keksoid/charybdis-wireless-mini-trackball-displaydongle/case/travel/preview/base.png

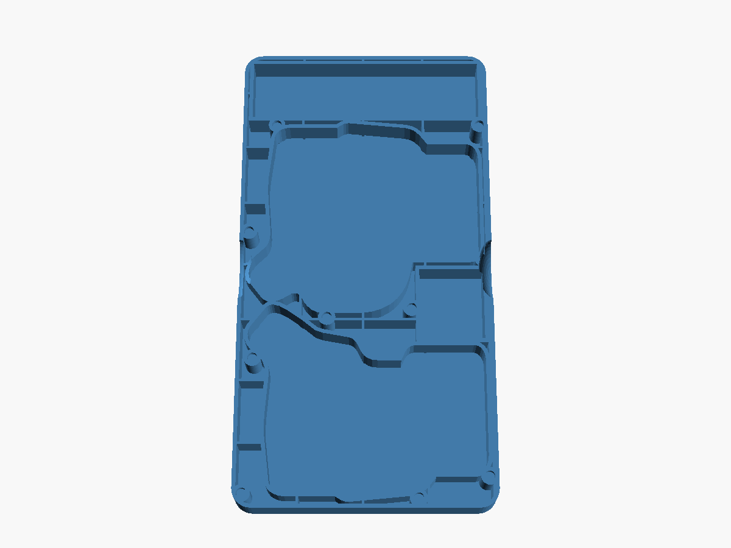
case/travel/preview/base.png
