keksoid/charybdis-wireless-mini-trackball-displaydongle/case/travel/preview/lid_inside.png

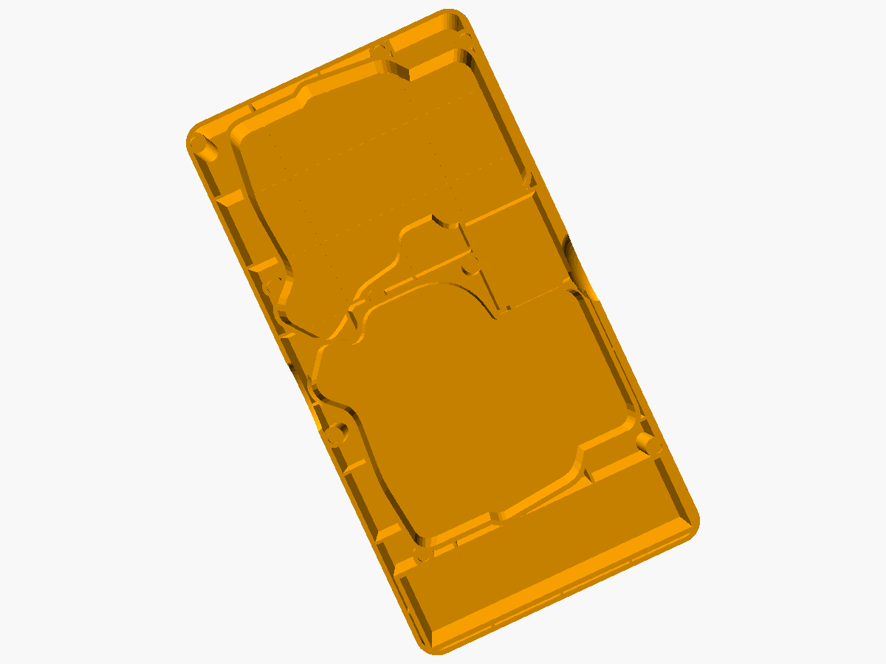
case/travel/preview/lid_inside.png
