keksoid/charybdis-wireless-mini-trackball-displaydongle/case/travel/stl/travel_case_base_fdm.stl

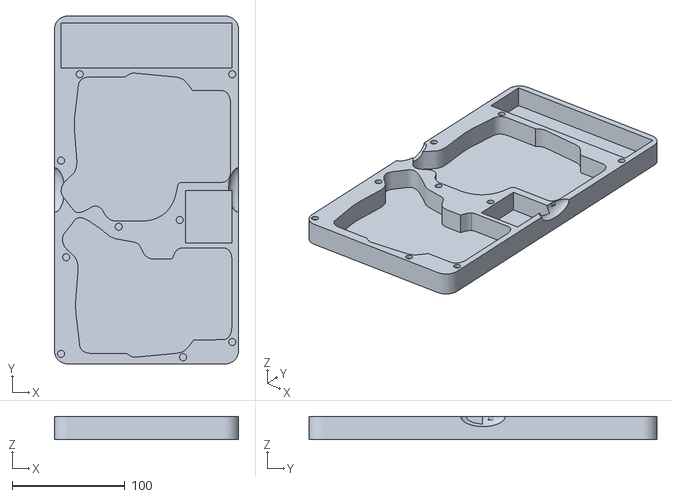
[picture p5: CAD file, 2026-11-10]
case/travel/stl/travel_case_base_fdm.stl
163.2 x 308.1 x 20.5
