keksoid/charybdis-wireless-mini-trackball-displaydongle/case/travel/stl/travel_case_lid_fdm.stl

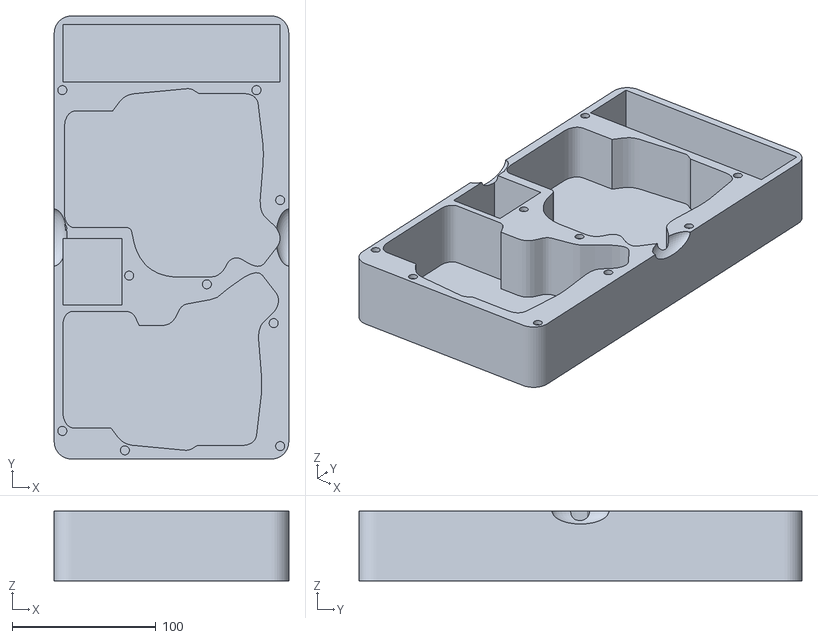
[picture p6: CAD file, 2026-11-10]
case/travel/stl/travel_case_lid_fdm.stl
163.2 x 308.1 x 48.5
