keksoid/charybdis-wireless-mini-trackball-displaydongle/case/travel/stl/travel_case_test_frame.stl

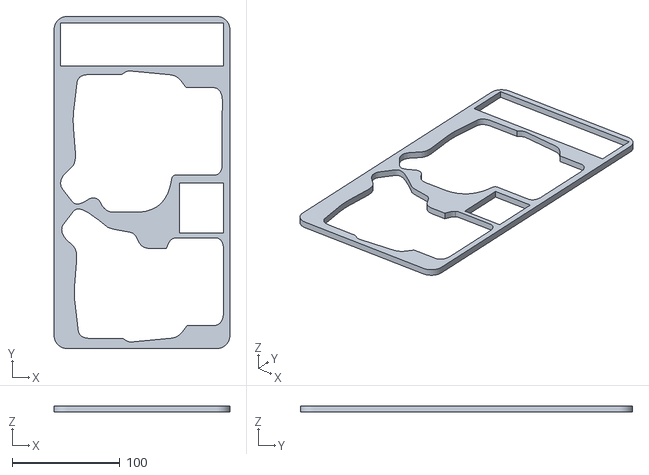
[picture p8: CAD file, 2026-11-10]
case/travel/stl/travel_case_test_frame.stl
163.2 x 308.1 x 6.00
