keksoid/charybdis-wireless-mini-trackball-displaydongle/case/travel/case_data.scad

// Generated by tools/build_case_data.py - do not edit by hand.
outer = [-130.76, -7.33, 32.41, 300.73];
z_pocket = -3.00; z_floor = -5.50; z_top = 63.50; clear = 0.00;
dongle_pocket = [-14.6, 99.9, 41.0, 46.2]; dongle_h = 53.50;
cable_pocket = [-124.76, 254.73, 151.17, 40.0];
magnets = [[-124.76, 1.67], [26.74, 249.17], [-124.76, 172.67], [26.74, 12.17], [-19.76, 120.17], [-120.26, 87.17], [-108.26, 249.17], [26.74, 153.17], [-73.76, 114.17], [-16.76, -1.33]];
module outline_left() polygon([[-123.65, 102.88], [-123.26, 105.48], [-122.22, 107.72], [-112.67, 120.09], [-111.62, 121.09], [-110.36, 121.8], [-109.03, 122.16], [-107.53, 122.21], [-104.01, 121.32], [-99.05, 118.69], [-89.12, 111.7], [-81.03, 105.13], [-76.39, 103.51], [-59.79, 100.47], [-57.64, 99.65], [-56.18, 98.53], [-54.96, 97.03], [-51.93, 91.08], [-50.15, 88.56], [-47.84, 86.8], [-45.01, 85.77], [-41.62, 85.4], [-26.72, 85.4], [-24.1, 91.07], [-22.94, 92.85], [-21.03, 94.47], [-18.57, 95.27], [19.21, 95.35], [20.86, 95.14], [22.25, 94.56], [23.87, 93.24], [25.09, 91.44], [25.96, 89.23], [26.4, 86.49], [26.4, 24.84], [25.97, 21.49], [24.77, 18.36], [23.59, 16.65], [22.31, 15.47], [20.84, 14.65], [19.03, 14.16], [-7.22, 14.07], [-11.88, 7.89], [-14.53, 5.24], [-16.13, 4.11], [-18.12, 3.13], [-21.87, 2.22], [-59.42, -1.33], [-61.26, -1.1], [-62.89, -0.55], [-66.99, 2.02], [-98.44, 2.05], [-101.73, 2.48], [-104.53, 3.58], [-105.81, 4.51], [-106.94, 5.76], [-107.79, 7.27], [-108.27, 8.8], [-111.71, 37.87], [-111.93, 43.86], [-111.79, 50.08], [-109.74, 75.77], [-109.81, 79.27], [-110.18, 82.03], [-111.1, 84.95], [-112.47, 87.23], [-119.55, 93.99], [-121.66, 96.57], [-123.18, 99.85]]);
module outline_right() polygon([[-124.76, 145.76], [-124.3, 149.03], [-122.79, 152.31], [-121.05, 154.53], [-113.56, 161.69], [-112.21, 163.96], [-111.3, 166.86], [-110.93, 169.65], [-110.86, 173.08], [-112.9, 198.85], [-113.04, 205.1], [-112.82, 211.12], [-109.38, 240.13], [-108.79, 241.9], [-108.06, 243.14], [-106.93, 244.39], [-105.65, 245.32], [-102.85, 246.42], [-99.56, 246.85], [-68.1, 246.88], [-64.04, 249.44], [-62.38, 250.0], [-60.53, 250.23], [-23.0, 246.68], [-19.28, 245.79], [-17.25, 244.79], [-15.65, 243.66], [-13.0, 241.02], [-8.34, 234.83], [17.86, 234.74], [19.7, 234.26], [21.13, 233.48], [22.42, 232.31], [23.46, 230.88], [24.74, 227.84], [25.29, 224.06], [25.28, 162.42], [24.84, 159.67], [23.98, 157.47], [22.76, 155.67], [21.17, 154.36], [19.79, 153.77], [18.24, 153.55], [-18.55, 153.55], [-19.61, 153.2], [-20.6, 152.51], [-21.36, 151.44], [-23.05, 143.28], [-24.14, 139.6], [-25.38, 136.45], [-27.54, 132.38], [-30.63, 128.3], [-32.56, 126.41], [-35.34, 124.25], [-40.05, 121.73], [-45.69, 119.98], [-51.31, 119.22], [-75.79, 119.11], [-79.42, 119.65], [-82.04, 120.9], [-84.41, 122.97], [-85.92, 124.87], [-88.34, 129.17], [-89.47, 130.52], [-91.21, 131.74], [-93.19, 132.42], [-95.56, 132.4], [-97.48, 131.84], [-103.07, 128.52], [-106.43, 127.12], [-108.91, 126.67], [-111.24, 127.01], [-112.7, 127.79], [-113.78, 128.79], [-123.03, 140.71], [-124.25, 143.01]]);
module ceiling_left() polyhedron(points=[[-128.65, -6.33, 61.0], [31.41, -6.33, 61.0], [-128.65, 127.23, 61.0], [31.41, 127.23, 61.0], [-128.65, -6.33, -4.0], [31.41, -6.33, -4.0], [-128.65, 127.23, -4.0], [31.41, 127.23, -4.0]], faces=[[0, 2, 3, 1], [4, 5, 7, 6], [0, 1, 5, 4], [1, 3, 7, 5], [3, 2, 6, 7], [2, 0, 4, 6]], convexity=6);
module ceiling_right() polyhedron(points=[[-129.76, 114.11, 55.0], [30.29, 114.11, 55.0], [-129.76, 255.23, 55.0], [30.29, 255.23, 55.0], [-129.76, 114.11, -4.0], [30.29, 114.11, -4.0], [-129.76, 255.23, -4.0], [30.29, 255.23, -4.0]], faces=[[0, 2, 3, 1], [4, 5, 7, 6], [0, 1, 5, 4], [1, 3, 7, 5], [3, 2, 6, 7], [2, 0, 4, 6]], convexity=6);
