keksoid/charybdis-wireless-mini-trackball-displaydongle/case/travel/preview/test_frame.png

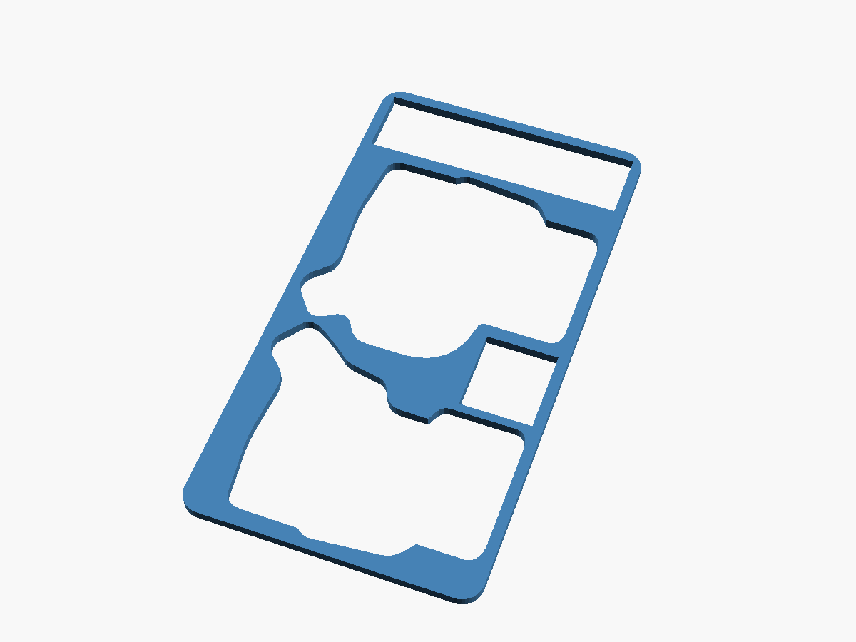
case/travel/preview/test_frame.png
