keksoid/charybdis-wireless-mini-trackball-displaydongle/(commit log)

2026-02-21 changed from lt to mo to quicker switch to temp layer
2026-03-26 ## Increase peripheral BLE thread stack — default 756 bytes is too small for BLE + PMW3610 SPI ## Dongle is always powered — sleep causes system-off with no self-wake (looks like a hang)
2026-10-20 Merge the Russian layer into the base layer
    The RUS layer sent the same key codes as BASE for almost every key, so
    BASE already types Russian when the OS language is Russian. Keeping a
    separate layer meant the layer and the OS language could get out of
    sync.
    - Remove the RUS layer. Layers after it move down by one:
    NUM 1, NAV 2, SYM 3, EXTRAS 4, SLOW 5, SCROLL 6, FUNC 7.
    Update all references: thumb keys, tap-dances, the precision mouse
    combo and the scroll/slow-pointer input processors.
    - BASE key 0: one tap switches the OS language (Win+Space).
    Remove the td_layers_0 / td_layers_1 tap-dances.
    - BASE key 11: [ instead of Delete (gives Х in Russian).
    BASE key 35: ] instead of ?/!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
2026-10-20 Switch to the SYM layer only when another key is pressed
    The Esc/SYM thumb used a tap-preferred hold-tap (170 ms), so a quick
    hold + symbol key often gave Esc and a letter instead of the symbol.
    Replace lt_nav with ht_esc_layer, set up like the space and backspace
    thumbs: balanced, tapping-term 200 ms, quick-tap 175 ms. A key pressed
    and released while the thumb is held now comes from SYM.
    Unlike the space and backspace thumbs, it has no require-prior-idle-ms
    (symbols often follow a letter directly, e.g. "foo(") and no retro-tap
    (holding and releasing the thumb alone sends nothing), because an
    accidental Esc can close a dialog or leave an editor mode.
    Double tap still holds the SLOW layer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
2026-10-20 Fix dongle freezes and halves not working after sleep
    Dongle freeze (screen stops updating, keys and pointer stop working):
    - Patch zmk-dongle-screen 0.1.2: the modifier widget called
    lv_label_set_text() every 100 ms from a k_timer callback, which runs in
    interrupt context. LVGL is not thread-safe, so this could corrupt LVGL
    state during a redraw. Use an LVGL timer (runs on the display work
    queue) and only update the label when the modifiers change.
    One half does not work after waking from sleep:
    - Set CONFIG_BT_L2CAP_TX_BUF_COUNT=10 on the dongle. When both halves
    reconnect at the same time, the 5 ATT request slots of ZMK v0.3.0 run
    out and GATT discovery for one half fails, so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
2026-10-24 Add a combined travel case for both halves, dongle and cable
    One flat case (161 x 304 x 68 mm) with a base and a lid that close with
    9 pairs of 6 x 3 mm magnets. It holds both keyboard halves, the display
    dongle (standing on its rear cap) and a coiled 1 m USB cable.
    - The keyboard pockets are the inside of f3rn4nd0d's Charybdis Mini
    Travel Case (CC BY-NC-SA 4.0): the wall outline of each closed half
    and the cover ceiling as a 1 mm height map, with 1 mm extra space
    above the keycaps.
    - Hollow construction for online printing (SLA/MJF): 2.5 mm skins,
    ribs every 40 mm, solid posts around the magnets. The hollows open
    at the base/lid joint, so nothing is trapped. About 740 cm3 instead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
2026-10-25 Add solid travel case files for FDM printing
    The hollow files are meant for SLS, MJF and SLA. On an FDM printer the
    lid's pocket ceilings would need supports inside closed hollows. Add a
    `hollow` option to the model and export a solid set: the slicer adds
    infill instead.
    - combined_case.scad: `hollow` option and a `lid_print` part (lid
    turned over, flat top on the bed, pockets up, no supports needed).
    - tools/build.py: also exports travel_case_base_fdm.stl and
    travel_case_lid_fdm.stl.
    - README: FDM files, material advice (PCTG or PETG, not PLA) and print
    settings.
2026-10-25 Ignore Python cache files in the travel case tools
2026-10-27 Use flat lid ceilings sized from the measured keyboard height
    The curved ceiling of the original travel case was made for XDA/HSA
    keycaps. The custom thumb keys are taller: the left half is 62 mm high
    at the thumb keys, which does not fit under that ceiling. The right
    half is 56 mm high (keycap and trackball top).
    - tools/build_case_data.py: CEILING = "flat" (new default) gives each
    lid pocket a flat ceiling at KEYBOARD_HEIGHT + 2 mm (left 64 mm,
    right 58 mm above the pocket floor). "original" keeps the old curved
    ceiling.
    - The case is 1.3 mm taller (69 mm). The base and its pocket outlines
    are unchanged, so the test frame stays valid.
    - The lid uses less material: 483 cm3 hollow,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
2026-10-30 Fix zero-thickness floor sheets in the test frame STL
    The test frame was cut exactly at the pocket floor height. The pocket
    floors and the floor of the hollow space lay on that cut, so they stayed
    in the STL as flat sheets with no thickness. The print lab could not
    print the file.
    - Cut the pocket openings 1 mm lower, so they go fully through the frame.
    - Export the test frame from the solid model. It is now about 80 cm3
    and works for every print process.
2026-11-03 Remove non-manifold edges at the finger notches
    The finger notch sphere was centred on the outer wall, and one ring of
    its points lay exactly in the wall plane. This left 24 edges shared by
    more than two triangles in the base and lid STL files. The sphere is now
    turned a half step, so no points lie in that plane.
    All five STL files are now closed meshes with every edge shared by
    exactly two triangles. The FDM files have no overhangs.
2026-11-10 Rotate the FDM lid instead of mirroring it
    The lid print file was turned over with a mirror. When the printed lid
    is turned over by hand, it became a mirror image of the lid that fits
    the base, so the pockets did not line up. The lid is now rotated
    180 degrees. Turned over, the new file matches the closed lid exactly.
    The open preview used the same mirror and showed the wrong lid. It now
    uses the same rotation.
2026-11-10 Add a 1 mm fit gap around the keyboard pockets
    The PETG print of the original pocket outlines was too tight. The
    keyboard halves did not go in fully, and the firm plastic was hard to
    trim by hand.
    - Grow each keyboard pocket by 1 mm on every side (FIT_GAP).
    - Move the right pocket 2 mm further away, so the divider stays 4.5 mm.
    - The case is now 163.2 x 308.1 x 69 mm, with 10 magnet positions.
    Every magnet hole still has at least 1.5 mm of material around it.
